vismay5559/zeus_26/zeus_description/meshes/IMU-1.stl

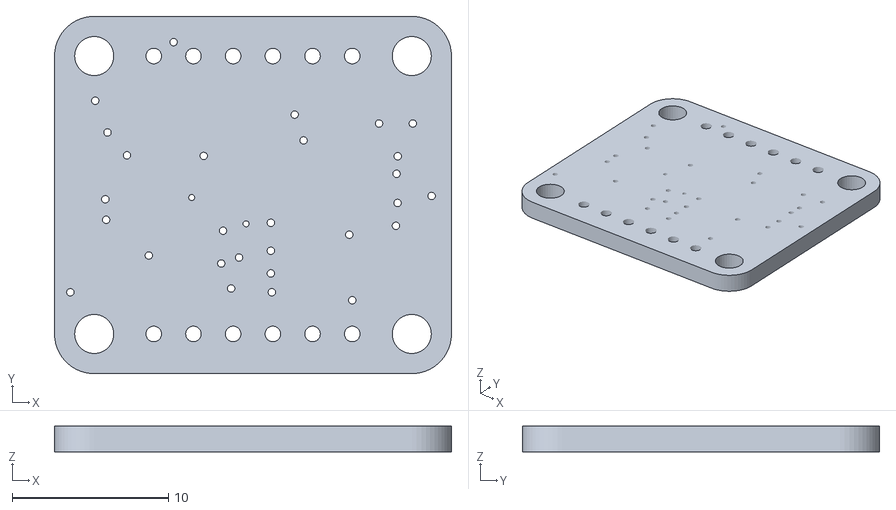
[picture p1: CAD file, 2026-09-30]
zeus_description/meshes/IMU-1.stl
25.4 x 22.9 x 1.65
