vismay5559/zeus_26/zeus_description/meshes/Hip_pitch_left.stl

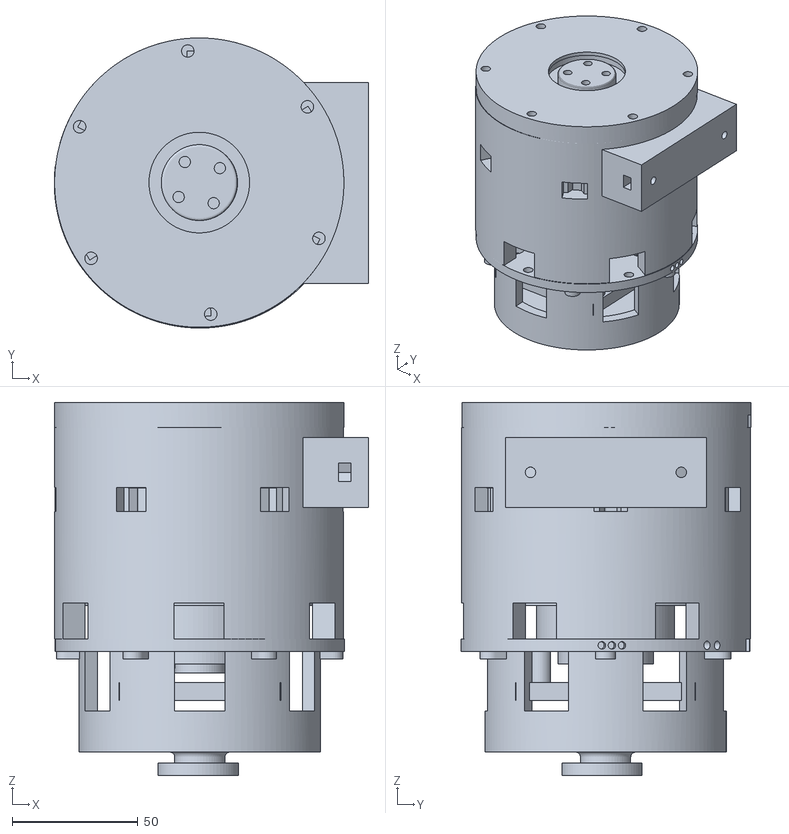
[picture p2: CAD file, 2026-09-30]
zeus_description/meshes/Hip_pitch_left.stl
125.0 x 115.3 x 148.3
