vismay5559/zeus_26/zeus_description/meshes/Hip_Spring_left.stl

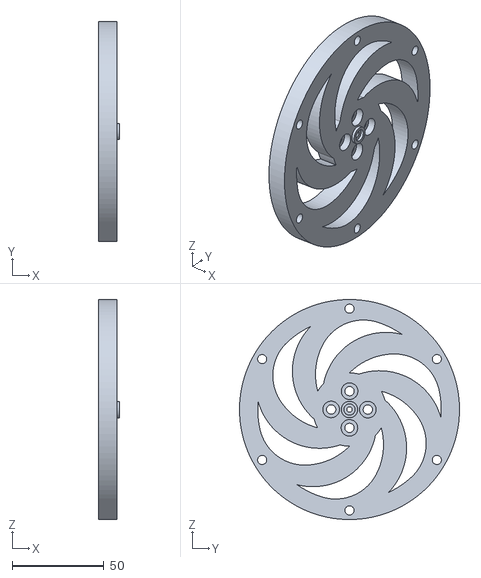
[picture p3: CAD file, 2026-09-30]
zeus_description/meshes/Hip_Spring_left.stl
11.5 x 120.0 x 120.0
