vismay5559/zeus_26/zeus_description/meshes/knee_brackett_left.stl

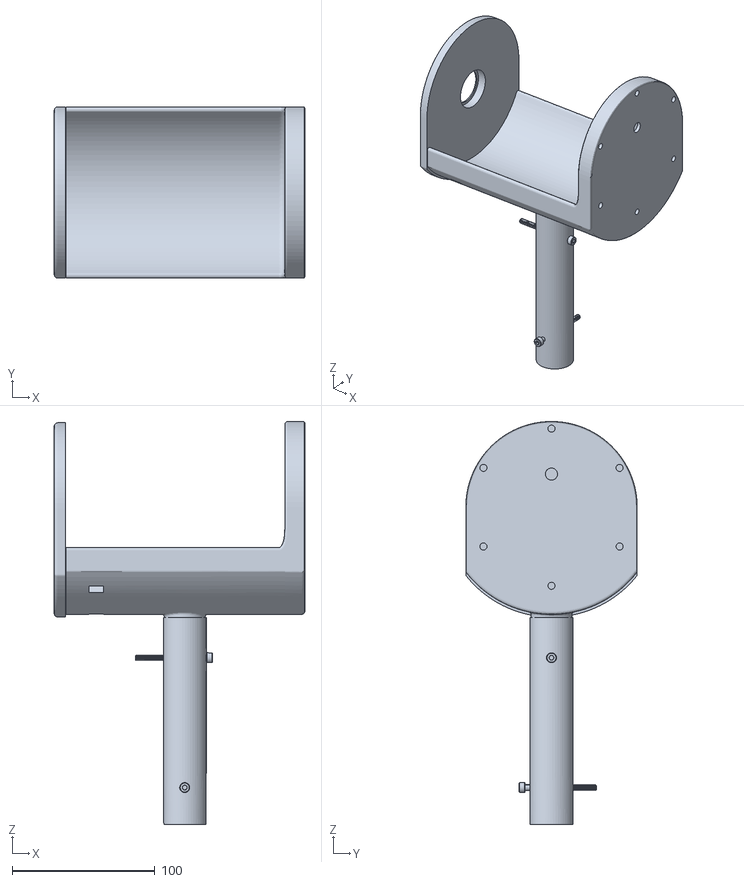
[picture p4: CAD file, 2026-09-30]
zeus_description/meshes/knee_brackett_left.stl
175.4 x 120.0 x 282.0
