vismay5559/zeus_26/zeus_description/meshes/hip_roll_brackett_left.stl

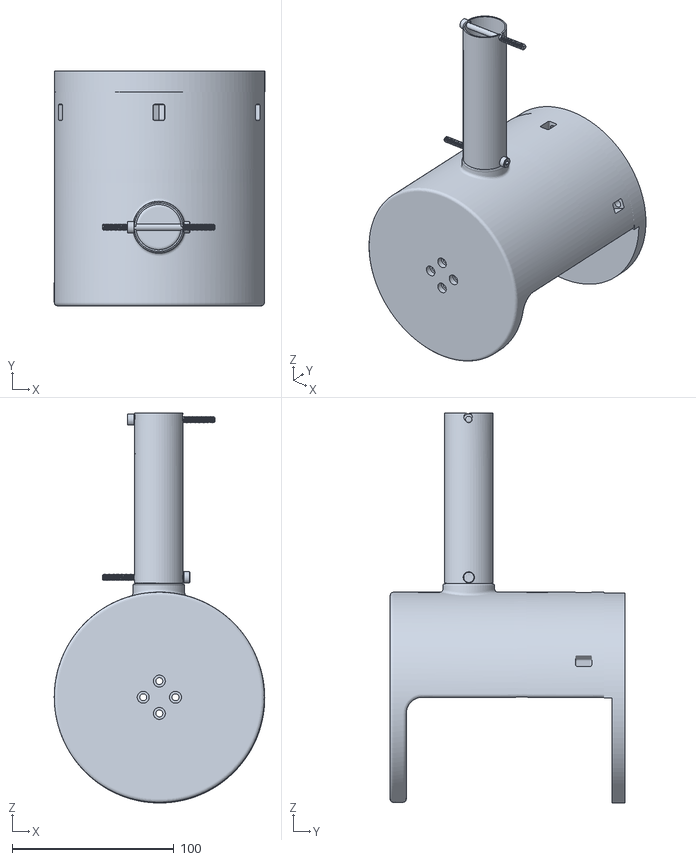
[picture p5: CAD file, 2026-09-30]
zeus_description/meshes/hip_roll_brackett_left.stl
130.2 x 145.2 x 241.2
