vismay5559/zeus_26/zeus_description/meshes/knee_actuator_left.stl

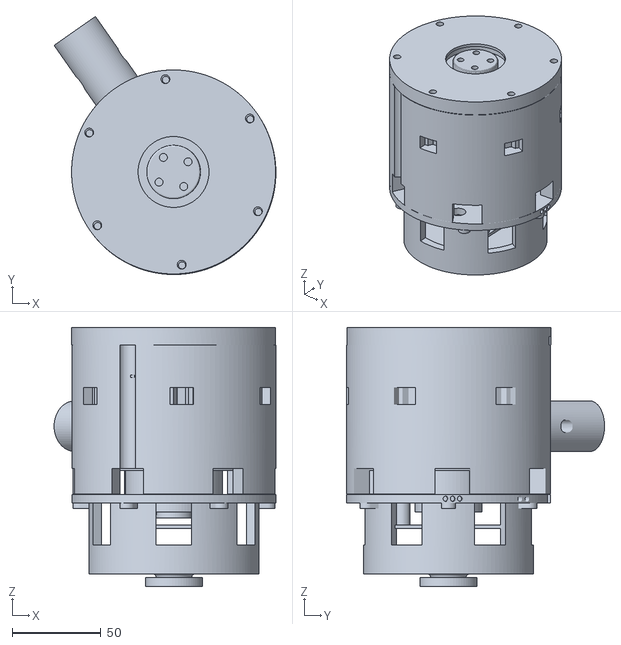
[picture p6: CAD file, 2026-09-30]
zeus_description/meshes/knee_actuator_left.stl
125.1 x 145.5 x 146.0
