vismay5559/zeus_26/zeus_description/meshes/hip_pitch_bracket_left.stl

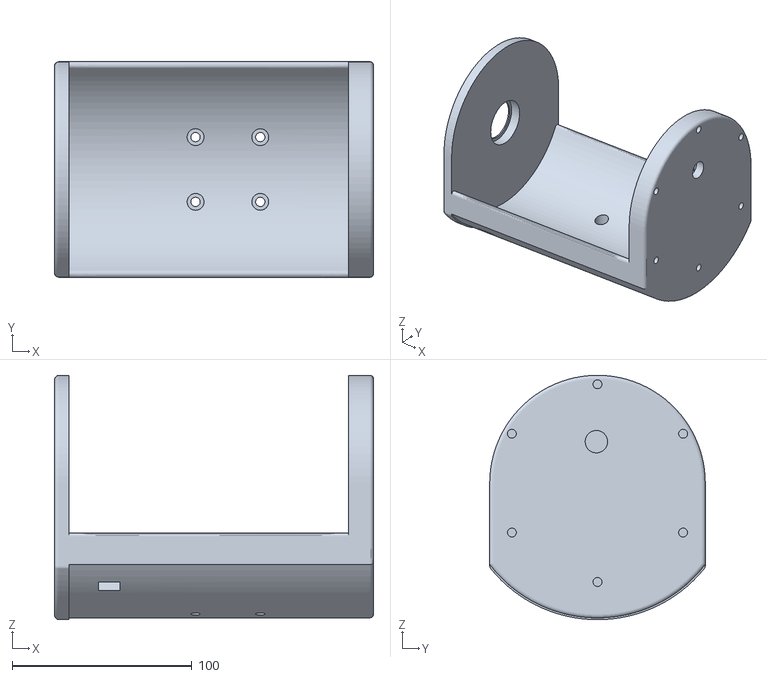
[picture p7: CAD file, 2026-09-30]
zeus_description/meshes/hip_pitch_bracket_left.stl
177.5 x 120.0 x 136.0
