vismay5559/zeus_26/zeus_description/meshes/hip_roll_acc_left.stl

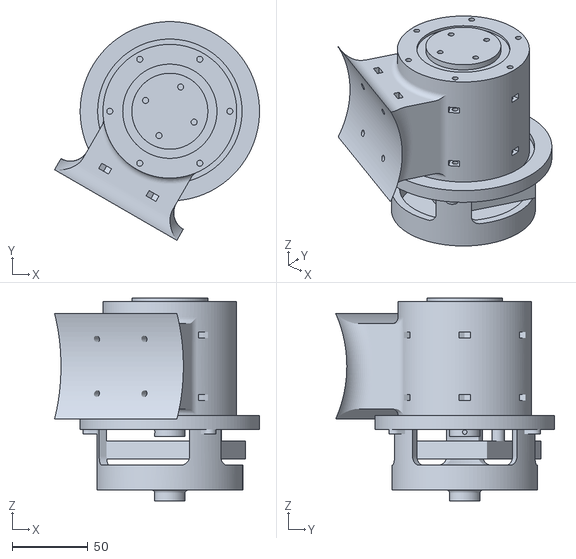
[picture p8: CAD file, 2026-09-30]
zeus_description/meshes/hip_roll_acc_left.stl
134.9 x 144.0 x 133.3
