vismay5559/zeus_26/zeus_description/meshes/foot_left.stl

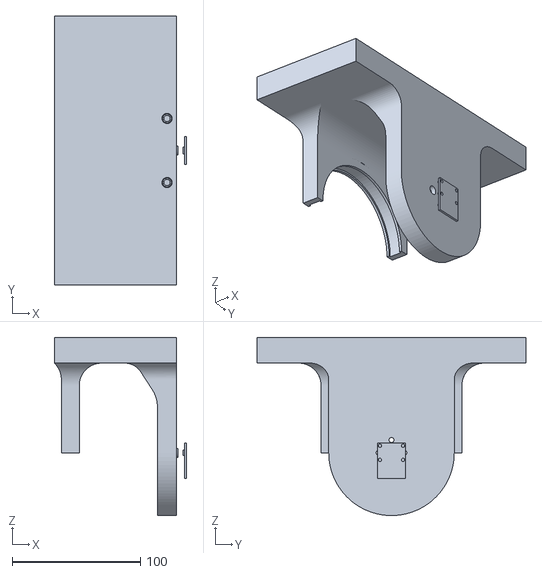
[picture p9: CAD file, 2026-09-30]
zeus_description/meshes/foot_left.stl
103.4 x 210.0 x 139.0
