vismay5559/zeus_26/zeus_description/meshes/Knee_spring_left.stl

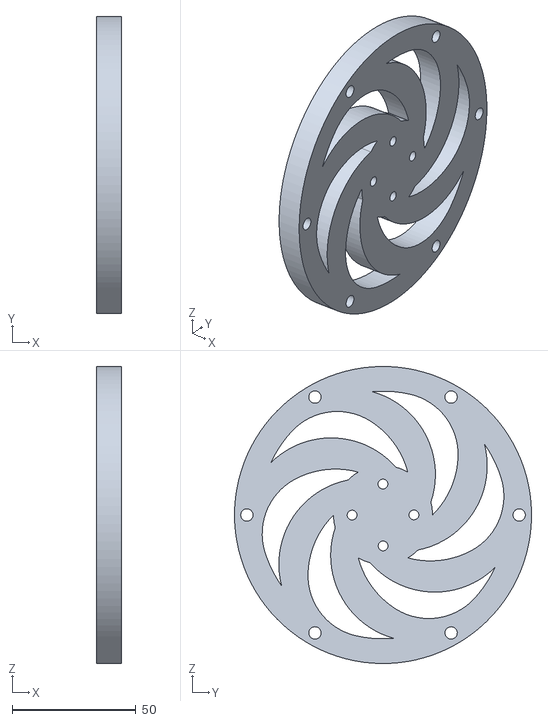
[picture p10: CAD file, 2026-09-30]
zeus_description/meshes/Knee_spring_left.stl
10.0 x 120.0 x 120.0
