vismay5559/zeus_26/zeus_description/meshes/base_link.stl

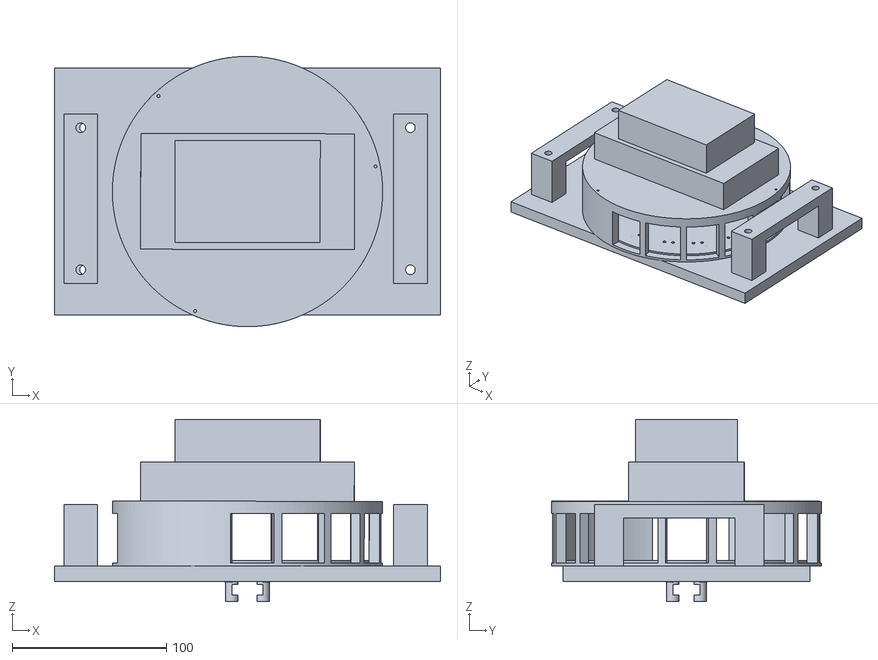
[picture p11: CAD file, 2026-09-30]
zeus_description/meshes/base_link.stl
249.9 x 175.0 x 118.0
