vismay5559/zeus_26/zeus_description/meshes/Ankel_left.stl

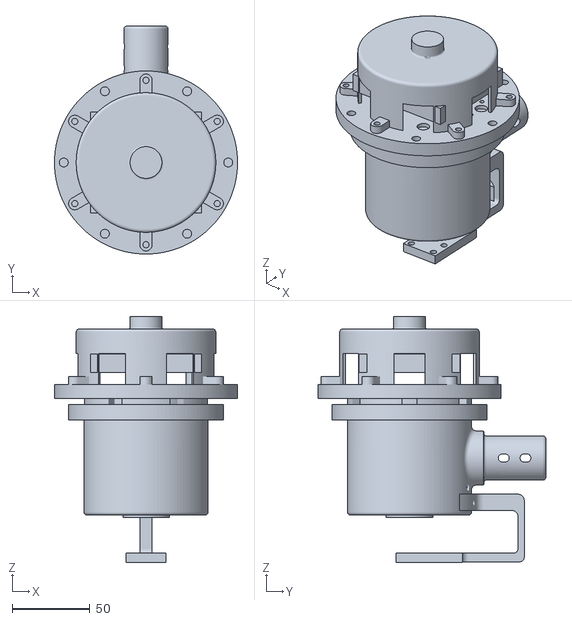
[picture p12: CAD file, 2026-09-30]
zeus_description/meshes/Ankel_left.stl
118.0 x 147.0 x 158.5
