vismay5559/zeus_26/(list of files, cad)

Other CAD files:
zeus_description/meshes/hip_roll_acc_right.stl
zeus_description/meshes/Hip_roll_bracket_right.stl
zeus_description/meshes/Foot_right.stl
zeus_description/meshes/Hip_pitch_right.stl
zeus_description/meshes/Hip_spring_right.stl
zeus_description/meshes/Knee_spring_right.stl
zeus_description/meshes/hip_pitch_bracket_right.stl
zeus_description/meshes/knee_brackett_right.stl
zeus_description/meshes/knee_right.stl
zeus_description/meshes/Ankel_right.stl
