vismay5559/zeus_26/zeus_description/urdf/zeus_raw.urdf

<?xml version='1.0' encoding='utf-8'?>
<robot name="leg_leg_leg">
    <link name="knee_brackett_right">
        <inertial>
            <origin xyz="-0.05256485378108973 -3.149811705671357e-06 0.06426097779759125" rpy="0.0 -0.0 0.0" />
            <mass value="0.26171359081742096" />
            <inertia ixx="0.001196914978362476" iyy="0.0017501326565231446" izz="0.0010754153665700275" ixy="-1.4104953642034843e-07" iyz="9.202998216265219e-09" ixz="8.98481223465422e-05" />
        </inertial>
        <visual name="knee_brackett_right_visual">
            <origin xyz="-0.0008604665059515782 -3.3166370208559394e-09 0.10360900149014901" rpy="3.141592653589793 1.5707963267948934 0" />
            <geometry>
                <mesh filename="meshes/knee_brackett_right.stl" scale="0.001 0.001 0.001" />
            </geometry>
        </visual>
        <collision name="knee_brackett_right_collision">
            <origin xyz="-0.0008604665059515782 -3.3166370208559394e-09 0.10360900149014901" rpy="3.141592653589793 1.5707963267948934 0" />
            <geometry>
                <mesh filename="meshes/knee_brackett_right.stl" scale="0.001 0.001 0.001" />
            </geometry>
        </collision>
    </link>
    <link name="Hip_roll_bracket_right">
        <inertial>
            <origin xyz="2.1558507816106242e-05 0.05396323849478971 0.033302675126960536" rpy="0.0 -0.0 -8.75111523449223e-62" />
            <mass value="0.2593953363423353" />
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
        <parent link="knee_actuator_left" />
        <child link="Knee_spring_right" />
        <axis xyz="0.9999889999999998 0.004484999999999944 0.001104" />
    </joint>
    <joint name="Knee_spring_right_Revolute-17" type="continuous">
        <origin xyz="0.014999840000000014 6.727000000000206e-05 1.6549999999959653e-05" rpy="-3.141592653589793 -1.5707963267948966 0" />
        <parent link="Knee_spring_right" />
        <child link="knee_brackett_left" />
        <axis xyz="0.0011039999999999997 -0.004485 0.999989" />
    </joint>
    <joint name="Ankel_left_Revolute-19" type="continuous">
        <origin xyz="-0.038446619999999994 0.0001725500000000002 0.04804246" rpy="-2.1599340154984659e-19 -2.2171418266626333e-19 -2.130031436354674e-19" />
        <parent link="Ankel_left" />
        <child link="foot_left" />
        <axis xyz="-0.999989 0.004485 0.0011040000000000006" />
    </joint>
    <joint name="hip_pitch_bracket_right_Rigid-45" type="fixed">
        <origin xyz="-0.07312906000000012 0.018203900000000002 -0.08869976999999998" rpy="-3.141592653589793 6.07576109200659e-39 -1.3552527156068808e-20" />
        <parent link="hip_pitch_bracket_right" />
        <child link="hip_roll_acc_right" />
    </joint>
    <joint name="hip_pitch_bracket_left_Rigid-46" type="fixed">
        <origin xyz="-0.07286658000000017 -0.017805650000000003 -0.08888396" rpy="-3.141592653589793 1.2037062152420227e-35 -1.3552527156068808e-20" />
        <parent link="hip_pitch_bracket_left" />
        <child link="hip_roll_acc_left" />
    </joint>
    <joint name="Hip_roll_bracket_right_Rigid-48" type="fixed">
        <origin xyz="0.0004410700000000034 0.03865789000000001 0.17581153000000002" rpy="1.9721522630525295e-31 -3.4512664603419266e-31 5.551115123125802e-17" />
        <parent link="Hip_roll_bracket_right" />
        <child link="knee_right" />
    </joint>
    <joint name="hip_roll_brackett_left_Rigid-49" type="fixed">
        <origin xyz="-7.367000000000346e-05 -0.038659050000000014 -0.1758100700000001" rpy="3.1415926535897745 -1.0011929436545832e-18 2.704926097982091e-19" />
        <parent link="hip_roll_brackett_left" />
        <child link="knee_actuator_left" />
    </joint>
    <joint name="knee_brackett_right_Rigid-50" type="fixed">
        <origin xyz="-0.22240434999999997 -1.2490009027033011e-17 0.06958225999999999" rpy="5.551115123125783e-17 -1.5707963267948966 0" />
        <parent link="knee_brackett_right" />
        <child link="Ankel_right" />
    </joint>
    <joint name="knee_brackett_left_Rigid-51" type="fixed">
        <origin xyz="-0.22248103 0.0003116700000000125 -0.06936809000000001" rpy="-5.55107277147842e-17 -1.5707963267948963 0" />
        <parent link="knee_brackett_left" />
        <child link="Ankel_left" />
    </joint>
    <joint name="base_link_Rigid-53" type="fixed">
        <origin xyz="0.05309447999821324 0.026587670011303938 0.6892580900028281" rpy="3.141523771073645 0.0005516016747925701 -0.0022425458152757066" />
        <parent link="base_link" />
        <child link="Hip_pitch_right" />
    </joint>
    <joint name="base_link_Rigid-54" type="fixed">
        <origin xyz="-0.0866735451213116 0.026559840567045447 0.6892580895544036" rpy="3.141523771073645 0.0005516016747925701 -0.0022425458152757066" />
        <parent link="base_link" />
        <child link="Hip_pitch_left" />
    </joint>
    <joint name="base_link_Rigid-55" type="fixed">
        <origin xyz="-0.025821939089959448 -0.012322293212967468 0.6806080832520717" rpy="-6.888251614786907e-05 0.0005516016747925701 -0.0022425458152757066" />
        <parent link="base_link" />
        <child link="IMU-1" />
    </joint>
</robot>
