vismay5559/zeus_26/(commit log)

2026-04-05 added hardware interface
    [zeus.ros2_control.xacro, zeus_controllers.yaml]
2026-04-06 changed urdf file name
    [zeus_ros2_control.xacro]
2026-05-31 changed interfaces+inekf
    [single_actuator_command_test.urdf.xacro, zeus_controllers.yaml, zeus_ros2_control.xacro, zeus_urdf.xacro]
2026-05-31 final change hardware interfaces
    [zeus_ros2_control.xacro]
2026-06-06 final rpi test single actuator
2026-06-11 running hip actuator
    [single_joint_controllers.yaml, single_joint_test.xacro, single_joint_test_robot.xacro]
2026-06-17 added QDD part
    [zeus_controllers.yaml, zeus_ros2_control.xacro]
2026-07-06 added backlash test
2026-07-06 added actuator fault
    [zeus_controllers.yaml, zeus_ros2_control.xacro]
2026-09-14 Rebuild the Pi workspace around the STM32 link
    The robot's hardware now belongs to the STM32. It reads the IMU, the spring
    encoders, the foot switches and both CAN buses, runs the state estimator, plays
    the reference gait and makes every safety decision, and streams the result to
    the Pi over USB OTG HS: a 444-byte state packet every millisecond. The Pi
    answers at ~250 Hz with a 52-byte residual that the STM32 adds to the gait.
    This workspace was built for the opposite arrangement - the Pi driving CAN, SPI,
    UART and GPIO itself - so almost none of it applied. It is now organised around
    that one link.
    Added
    zeus_msgs NexusState.msg and NexusCommand.msg, field for field with the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
    [single_actuator_command_test.urdf.xacro, single_joint_controllers.yaml, single_joint_test.xacro, single_joint_test_robot.xacro, zeus.urdf.xacro, zeus_controllers.yaml, zeus_ros2_control.xacro, zeus_urdf.xacro]
2026-09-14 Skip the generated-message test unless the class really exists
    The plain-Python CI job runs pytest from the workspace root. There, the source
    folder zeus_msgs/msg/ - which holds only .msg files - imports as an empty
    namespace package, so pytest.importorskip("zeus_msgs.msg") succeeded and the
    test failed looking for NexusState. It now also requires the generated class.
    The test itself was right: in the colcon job, against the message class rosidl
    generated, it ran and passed.
    [test_convert.py]
2026-09-15 Fix two bugs found running the Pi stack against a fake board
    Tested on Ubuntu 24.04 with ROS 2 Jazzy for the first time, against a fake
    STM32 on a pseudo-terminal. Both bugs passed every unit test and would have
    shown up on the robot.
    1. link_node stopped publishing /zeus/state at the first FAULT.
    `(log.warn if name == "FAULT" else log.info)(...)` logs at two severities
    from one call site, which rclpy forbids; it raised ValueError inside the
    publish thread and ended it. Commands kept flowing, so a policy would have
    gone on acting on a frozen observation at exactly the moment the robot
    faulted. The call is split in two, and the publish loop now logs and
    survives any excepti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
    [e2e_fake_board.py, fake_board.py, gait_passthrough_node.py, link_node.py]
2026-09-15 Recognise the leg test's USB stream, and show it live in degrees
    stm32_zeuss 16bd04f makes the single-leg bench test send the robot's state
    packet over USB at 1 kHz, flagged NEXUS_STREAM_LEG_TEST. This is the Pi side:
    nexus_proto.py re-copied from the firmware repo at 16bd04f: STREAM_LEG_TEST
    NexusState.msg STREAM_LEG_TEST=2, checked against the protocol by the tests
    link_node logs the source once - "the STM32 single-leg bench test ...
    Only its joints are real, and the board ignores commands" -
    so a bench stream is never mistaken for the robot
    link_check a ROBOT / LEG TEST column
    zeus_rerun degrees: `rerun_serial --degre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
    [link_check.py, link_node.py, nexus_proto.py, test_msg_matches_proto.py]
2026-09-16 Generate the model from the Fusion 360 export
    zeus.urdf.xacro was a hand-made stick figure with placeholder lengths. The
    model now comes from the CAD: urdf/zeus_raw.urdf is the export untouched,
    config/zeus_model.yaml holds what the export does not know, and
    scripts/clean_urdf.py combines them into urdf/zeus.urdf.
    The clean-up puts base_link at the hip centre with X forward / Y left / Z up,
    names the links and the 14 moving joints (the 10 of the joint map plus the
    hip and knee spring joints), makes pitch joints turn about +Y and roll joints
    about +X on both legs, and adds imu_link and the left/right toe and heel
    contact frames. --suggest measures those frames from the meshes.
    Checked again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
    [Actuator-Knee-Right.stl, Actuator-Left.stl, Actuator-Right.stl, Foot-Right.stl, Foot-left.stl, Hip-Left.stl, Hip-Right.stl, Hip-Roll-Actuator-Left.stl]
2026-09-16 Limit every joint to +/-45 degrees
    The placeholder limits were +/-pi on the joints and +/-0.2 rad on the
    springs. They are now +/-45 deg (0.7854 rad) on all 14 moving joints,
    springs included, until the real mechanical stops are known.
    The toe and heel frames keep their assumed spots, at the front and rear
    edge of each sole: the switch positions are not final yet.
    [zeus.urdf]
2026-09-16 Name the spring encoders in spring_angle order
    The STM32 now reads the four AS5047P spring encoders as two chains, one
    per leg, into a fixed order: left hip pitch, left knee pitch, right hip
    pitch, right knee pitch. nexus_proto.py gains ENC_* and SPRING_NAMES, and
    NexusState.msg says the same, so nothing on the Pi has to guess.
    [nexus_proto.py]
2026-09-20 Two legs, no waist: eight joints and protocol v7
    TEMPORARY, not the final robot: the Pi side of the STM32's two-leg build
    (stm32_zeuss 8e66991). The tag waist-10-actuators marks the last workspace
    with ten.
    - NexusState and NexusCommand carry 8 joints, not 10, and the J_* indices
    renumber the right leg from 5..8 to 4..7.
    - nexus_proto.py follows the firmware: v7, state 400 bytes, command 44,
    policy block 46 floats. A v6 board and a v7 Pi reject each other, so
    flash and update together.
    - /joint_states still carries waist_pitch and waist_roll at 0
    (BOLTED_JOINT_NAMES). The robot still has those parts and the URDF still
    has those joints; leaving them out of the message breaks the mo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
2026-09-20 CI: take the joint count from the protocol, not from a literal
    The generated-message check hard-coded 10 joints and a 52-float policy
    block, so the two-leg change turned it red. It now reads NUM_JOINTS and
    POLICY_COUNT from nexus_proto, and asserts the generated NexusState class
    agrees with them - which is the thing this step exists to catch, since
    those sizes are baked into the class at build time.
2026-09-20 zeus_rerun README: eight joint plots, not ten
    Left stale by the two-leg change.
2026-09-20 zeus: one command to check, stop, record and tune the robot
    NOT THE FINAL ROBOT - the Pi side of the two-leg bring-up build.
    Starting and watching the robot was a launch file and a lot of typing;
    tuning a drive's gains meant odrivetool on eight drives, by hand, with
    nothing written down. This adds the loop that replaces both:
    ros2 run zeus_bringup zeus check pre-flight, read-only
    ros2 run zeus_bringup zeus stop stand down now
    ros2 run zeus_bringup zeus record NAME record a run while it walks
    ros2 run zeus_bringup zeus tune NAME what that run says about the gains
    ros2 run zeus_bringup zeus gains ... show / push / set
    - check reads two seconds of /zeus/state and r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
    [convert.py, fake_board.py, link_node.py, nexus_link.py, nexus_proto.py, synthetic.py, test_msg_matches_proto.py]
2026-09-24 link_check: say why nothing is parsing
    "No packets - is the Appli running in NEXUS_MODE_ROBOT?" covered two
    unrelated faults and reported them identically: nothing arriving at all,
    and bytes arriving that this workspace cannot read. The second is what a
    protocol bump looks like from the Pi - cable, port and board all fine,
    and the message sends you to swap cables for an hour. We have bumped the
    version twice this week, so it is worth naming.
    link_check now reports which of the two it is, and when bytes are
    arriving it reads the version byte out of the raw stream and names it:
    "the board is sending protocol v7, this workspace speaks v8". NexusLink
    keeps the last 1 KB read so that is possible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
    [link_check.py, nexus_link.py, test_ports_and_link.py]
2026-09-26 link_validate: measure the 1 kHz link, and say which side is wrong
    link_check prints an arrival rate, which is one number covering two
    independent questions. 970 Hz can mean the board is ticking slowly and every
    tick arrived, or the board is at a clean 1000 Hz and the host dropped 3%.
    Opposite faults, opposite fixes, same number on the screen - and telling them
    apart means cross-checking the loss column by eye every time, which is exactly
    the step someone skips at 1am on a bench.
    link_validate measures each against a different clock and names the culprit:
    tick rate the board's seq counter over wall time. seq is stamped on the
    board, so this owes nothing to USB - it is t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
    [link_validate.py, nexus_link.py, test_link_validate.py]
2026-09-26 A held port is an answer, not a traceback
    Running link_check while something else holds the port is the normal mistake,
    not an exotic one - it is the first thing anybody tries. The exclusive lock
    makes it fail, which is the point, but it was failing as a two-deep pyserial
    traceback ending in "Resource temporarily unavailable". The one sentence that
    says what to do about it was buried under twenty lines of stack.
    start() now turns that errno into a PortError saying the port is already open
    and only one reader is allowed, and both CLIs print it and exit 1.
    start() is also idempotent now, because the fix required it: the CLIs open the
    port before entering the `with` block so the failure is re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
    [link_check.py, link_validate.py, nexus_link.py, test_link_validate.py]
2026-09-26 Judge the link by rates, and never let Ctrl-C skip the stand-down
    Two things this validator got wrong, both found by running it for real.
    It failed on `lost > 0` and on any gap over the policy period at all. That
    sounds strict and is useless: over a long enough soak a host will drop
    something eventually, so an hour-long run was guaranteed to fail and the
    verdict carried no information. A threshold nothing can pass is not a
    threshold, and a check that cries wolf gets ignored or deleted.
    Everything is a rate now, measured against what the robot actually needs. One
    lost packet is 1 ms of staleness, which a 250 Hz policy cannot see; one every
    other second is a link coming apart. Same for long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
    [link_node.py, link_validate.py, test_link_validate.py]
2026-09-28 One foot switch per foot, at the centre of the sole
    Each foot had two mechanical switches, at the toe and the heel, and the board
    reported which of them was loaded. There is one per foot now, so that question
    can no longer be asked: a foot is either taking weight or it is not.
    Where the single switch sits is the whole decision, because that point is what
    the InEKF pins the robot to while the foot is planted. The centre of the sole
    is the least biased choice - either edge is a position the robot genuinely
    stands on for only part of the stride, and anchoring there would bias the
    estimate towards the phase when that end happens to be down. So the new
    contact frame is the midpoint of the old to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
    [zeus.urdf]
2026-09-29 AGENTS.md: what someone needs before touching this robot
    Orientation for a person or an agent arriving cold. The map, the exact build
    and test commands, and - the part that actually matters - the list of things
    that have already cost days: the USB regulator that has to be OFF, the OTG DMA
    that has to stay off while the control buffers are cached, printf blocking the
    1 kHz loop, XSPI2, the non-cacheable DMA region, one reader per serial port.
    Each of those has a comment at the site explaining it. This collects them in
    one place so they are found before the mistake, not after.
    Also states the working conventions this repo actually follows, and where the
    robot currently stands - including wha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
2026-09-30 New CAD export: eight actuators, no waist in the model at all
    A fresh Fusion export replaces the whole model - new meshes, new part names,
    new axis convention. The important structural change is that it has no waist:
    both hips bolt straight to the torso, where the previous export still carried
    two waist joints that nothing drove.
    The export arrived as mukesh.urdf, duplicated at two paths. It is a RAW export,
    not a drop-in zeus.urdf: Fusion joint names, continuous joints with no limits,
    no imu_link, no contact frames, robot name "leg_leg_leg". So it goes in as
    urdf/zeus_raw.urdf, the pipeline's input, and zeus.urdf is generated from it as
    before. The duplicate copy is gone.
    zeus_model.yaml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
    [Actuator-Knee-Right.stl, Actuator-Left.stl, Actuator-Right.stl, Ankel_left.stl, Ankel_right.stl, Foot-Right.stl, Foot-left.stl, Foot_right.stl]
2026-09-30 The policy README described a packet two versions out of date
    zeus_control_interface/README.md is the contract a policy author builds the
    network's input from, and its observation table still described ten joints and
    52 values. The packet has carried eight joints since v7 and 44 values since v9,
    so every slice after vel_hdg was wrong: joint_vel's documented range overlapped
    the real spring_angle and ref_angle, and the template sized its residual for ten
    joints, which the message would have rejected.
    Nothing caught it because nothing read that table but people. A wrong slice
    there does not crash - it feeds joint velocities into inputs the network
    learned as joint positions, and the robot sim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
    [test_policy_readme.py]
2026-09-30 AGENTS.md: Pinocchio installs, at a pinned version
    It does not need to be CI-only. pin==2.7.0 with numpy<2 imports and runs both
    the reference generator and the walk simulation; the 3.x/4.x wheels are the ones
    that die on import. requirements-kinematics.txt carries the pins and the
    reasoning, and the command to run the simulation locally is here now.
